dydx-prime/CMOS-Inverter-Design/images/PMOS_single_sim.png

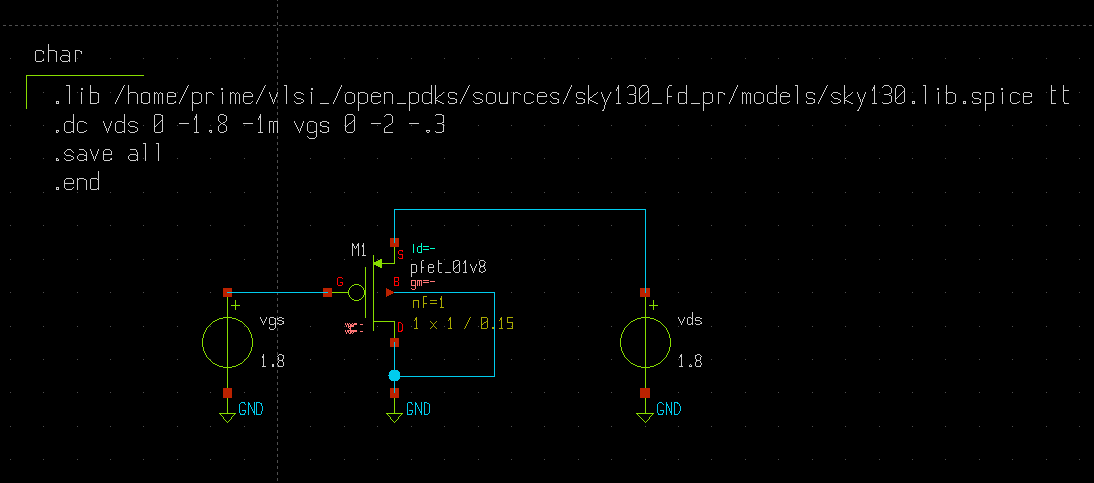
images/PMOS_single_sim.png
