dydx-prime/CMOS-Inverter-Design/todo.txt

Finish I-V of PMOS

Replace Formula for Average Power

Fix Figure numbers

Grammar

you have plenty of time.
