dydx-prime/CMOS-Inverter-Design/(commit log)

2025-07-02 power analysis done
    [inv.sch, not_symbol.sch, trans.sch]
2025-07-09 Almost Done
    [inv.sch]
2025-07-11 These are the last major changes, probably?
    [CMOS_inverter.sch, inverter_simulation.sch, transient_simulation.sch]
2025-08-08 grammar, structure, etc
    [transient_simulation.sch]
